diyruz/AirSense/hardware/BOM.xlsx

ID | Name | Designator | Footprint | Quantity
1 | LED0805 (https://s.click.aliexpress.com/e/_dZN8W9P) | LED1,LED2,LED3 | LED0805-RD | 3
2 | USB-A (https://s.click.aliexpress.com/e/_dVAItiN) | X1 | USB-A-SMD_POWER | 1
3 | USB_MICRO (https://s.click.aliexpress.com/e/_d8p8ppL) | X2 | MICRO-USB-POWER | 1
4 | 2.54x5pin | P1 | DIP-1X5P-2.54MM | 1
5 | 1K | R1,R2,R3 | R0805 | 3
6 | T.Switch3x4x2 (https://s.click.aliexpress.com/e/_dXtXN2h) | SW1,SW2 | SWITCH-3.0*4.0 | 2
7 | 10uF | C1 | CASE-B_3528 | 1
8 | DS18B20 | U2 | TO-92-3_L4.9-W3.7-P1.27-L | 1
9 | SenseAir S8 (https://s.click.aliexpress.com/e/_dXVJjSD) | D2 | SENSEAIR S8-REV1 | 1
10 | 22uF | C2 | CASE-B_3528 | 1
11 | E18-MS1PA1-PCB_CO2 (https://s.click.aliexpress.com/e/_d7DG1Wp) | D1 | E18-MS1PA1-PCB_CO2 | 1
12 | BME280 (https://s.click.aliexpress.com/e/_d8TRj7X) | D3 | LGA-8_BME280 | 1
13 | AMS1117-3.3 (https://s.click.aliexpress.com/e/_d8v8J7b) | U1 | SOT-223-4_L6.5-W3.5-P2.30-LS7.0-BR | 1
