diyruz/AirSense/(threads)

Thread 7 (2020-12-20):

Pressure = 10080000000000000, v.2.0.1

Fortunatto, 2020-12-20:
Датчик BME280. Шлюз SLS. Показания  в строке давления "Pressure = 10080000000000000". На прошивке 2.0.0 этой ошибки не было.

nurikk, 2020-12-21:
Maybe @xyzroe can help?

xyzroe, 2020-12-21:
@Fortunatto прошивка с гита или сам собирал?

xyzroe, 2020-12-21:
@nurikk your build DIYRuZ_AirSense_EndDevice_CC2591.hex uses 478,773 bytes.
The build from my fork uses 479,153 bytes.
Cloned the original repository just now, rebuilt it - uses 479,135 bytes.
The difference in the size of my builds is clear to me, but why is the difference between mine and your's build?
Some patches have not been applied?

xyzroe, 2020-12-21:
@Fortunatto попробуй из архива билд использовать
[Archive.zip](https://github.com/diyruz/AirSense/files/5726492/Archive.zip)

@nurikk just checked my build from a local fork and own build from the master branch - the pressure displays correctly.
uploaded the build from git - the pressure does not scale correctly. I think some patched have not been applied.

Fortunatto, 2020-12-21:
> @Fortunatto прошивка с гита или сам собирал?

С гита.

xyzroe, 2020-12-22:
@Fortunatto 3.0.1 ставь

Fortunatto, 2020-12-24:
> @Fortunatto 3.0.1 ставь, подключай внешний конвертер и будет ок
Поставил 3.0.1, подключил внешний конвертер. Возможно я "криворучка", но у меня исправилось давление, зато "сломалось" СО2: показывает 65535.

xyzroe, 2021-01-03:
> Поставил 3.0.1, подключил внешний конвертер. Возможно я "криворучка", но у меня исправилось давление, зато "сломалось" СО2: показывает 65535.

@Fortunatto проверяйте сенсор со2. он 65535 может выдавать сразу после включение, после должно нормализоваться

> Не в тему давления, но заметил еще одну особенность: Прошил датчик в роутер. Подключаю через USB-стик Modkam V3 и zigbee2mqtt. Датчик СО2 подключается. Но пока он работает, никакие другие новые датчики спарить не получается. Если датчик СО2 отключить от питания, спаривание новых устройств проходит нормально.

видимо у вас в стике прошивка но которой роутеры не корректно отрабатывают спаривание.
проблема к датчику СО2 отношения не имеет. в крайнем случае прошейте end конфигурацию.

@nurikk I think you can close this issue.

Closed 2021-02-28.

Thread 9 (2021-01-12):

return scaled value  for pressure

dmitrychepel, 2021-01-12:
scaled value for pressure was deleted. but it works properly in the previous version.
pls return scaled value for pressure.
without scaled value (and scale) pressure in sls gateway does not work.
also z2m in case of usage scaled values provide more accuracy values of pressure and after convert pressure to mmhg last sign is not lost.

Closed 2021-03-07.

Thread 10 (2021-01-24):

Sometimes both LED2 and LED3 blinking

doctor64, 2021-01-24:
Sensor SenseAir S8
Firmware 4.0.2 DIYRuZ_AirSense_Router_CC2591.hex
Firmware build date     18/01/2021 11:23
Firmware version         18/01/2021 11:23
Sensor works without any noticeable problems, but sometimes both LED2 and LED3 start blinking for ~30 seconds. LED1 not blink in this time.
Looks like this happen only when detected CO2 concentration below first margin, ie below 1000 ppm. When detected level is higher LEDs works as expected.
I checked the sources and found only one place where both LEDs going to blink - in zstack-lib/mhz19.c, function uint16 MHZ19_Read(void). Possible, firmware incorrectly detect connected sensor?

egony, 2021-11-21:
Same shit on 4.0.2.
When CO2 level changed with low difference (I mean CO2 level close to constant), sometimes leds blinks fast (same as without CO2 sensor installed).
When CO2 level changed fast (ie window opened), leds never blinks as described.

Diddlik, 2022-01-27:
Can only confirm have the same problem

Thread 14 (2021-04-05):

CC2591/CC2592 sensors: temperature "freezes"

crimean-celica, 2021-04-05:
I have "freezes" (only temp value) after 4.0.2 "router" flashing:
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

Can be solved by power off/on for some seconds (but you can see temp "spikes" after these off/on's)
Trying to return to the older version

crimean-celica, 2021-04-10:
Ok, a bit more information. I have 3 sensors, 2 * E18 MS1PA1-PCB + 1 * E18 MS1PA2-PCB
I tried to use all 4 images for all of them and got these results:
- MS1PA2 with "CC2591 device" has stability issues with the network - can leave the network in 1-2 weeks and you will need to remove/add it manually again to keep obtaining the data
- all of them have temperature issues with any "router" images: (1) all devices need "-5" additional calibration and (2) all of them stopped sending actual temperature as I said before
- all devices work stable with "CC2592 device" image

crimean-celica, 2021-04-10:
p.s.

I have an explanation for temperature "spikes" - these mean sensor re-heating. And I think it may (that should be additionally tested!) be avoided by proper sensor orientation - the device must be oriented in a way that provides the lowest position for the temperature sensor i.e. power "slot" should be at the bottom.

Thread 18 (2021-09-26):

[Feature request] Read temperature data from CO2 sensor

smartynov, 2021-09-26:
Thank you for this useful firmware. I wonder why do one need a separate DS18B20 sensor to return temperature data. AFAIK both Senseair S8 and MH-Z19 return air temperature in UART protocol. You can read it and return in absence of a separate sensor.

Thread 21 (2022-01-22):

After reflash firmware - can not pairing

Creo2005, 2022-01-22:
Please help me,
I managed to connect only 1 time, but I still did not understand how I did it.
I need to re-bind the sensor for for adding converter in Domoticz.
Which button to press: SW1, SW2?
Or power ON/OFF 5 times?
Thank's.

Closed 2022-01-27.

Thread 24 (2024-06-06):

BOM has broken links. Which SMD USB Micro connector can be used?

nchieng, 2024-06-06:
No activity here for a while. Hopefully someone is still watching the repo.
I'm hoping to use USB micro, and the AliExpress link on the BOM is dead.

I've found potential matches, and thought to check if anyone know which one would fit.

[Aliexpress Link](https://www.aliexpress.com/item/1005007082795070.html)
TYPE-C-17 or TYPE-C-18

Hope someone can help.
