diyruz/AirSense/(commit log)

2020-09-25 Fix switch/case break
2020-09-25 Invert abc parameter logic
    [zcl_app.c, zcl_app.h, zcl_app_data.c]
2020-09-25 Fix tx power for non PA build
    [preinclude.h]
2020-09-27 Fix uart on devboard
    [preinclude.h]
2020-09-27 Add BME280 calibration offsets
2020-09-29 Fix pressure offset data type
    [zcl_app.h, zcl_app_data.c]
2020-10-06 Fix sensor detection
2020-11-03 added СС2591 configurations
2020-11-06 fix select HAL_BOARD_INIT() by board type reduced INT_HEAP_LEN size for routers builds
    [hal_board_cfg.h, preinclude.h]
2020-12-19 Added power save mode tasks
2020-12-19 Power saving mode for Ends
    Define power saving mode in all end device configurations
2020-12-21 Fix broken comment in HAL_BOARD_INIT
    [hal_board_cfg.h]
2020-12-21 Fix PressureSensor_ScaledValue computation
2020-12-22 Fix PressureSensor_ScaledValue casting
2020-12-22 Fix invalid readings with 0 value
    [zcl_app.c]
2021-01-03 returned back scaled values and scale. to improve measurement accuracy and avoid hardcode in the sls
    [zcl_app.c, zcl_app.h, zcl_app_data.c]
2021-01-18 Revert "Deprecate scaled value"
    This reverts commit 5f468634508cfbc9ad94de0b667055912b8c7e35.
    [zcl_app.c, zcl_app.h, zcl_app_data.c]
2021-01-28 uploaded images and box.xlsx
    [BOM.xlsx]
